mr-d80/Arduino-XP-BMS-MkII/hardware/with-EL-switch/Arduino-XP-BMS-MkII-picture-assembly.jpg

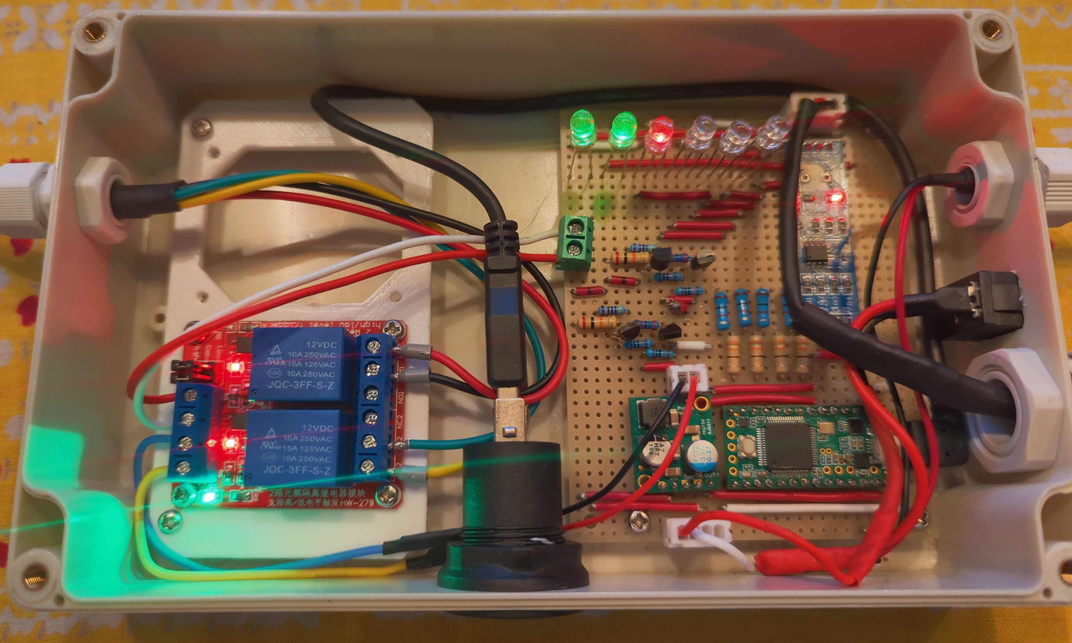
hardware/with-EL-switch/Arduino-XP-BMS-MkII-picture-assembly.jpg
