mr-d80/Arduino-XP-BMS-MkII/hardware/Arduino-XP-BMS-schematic.png

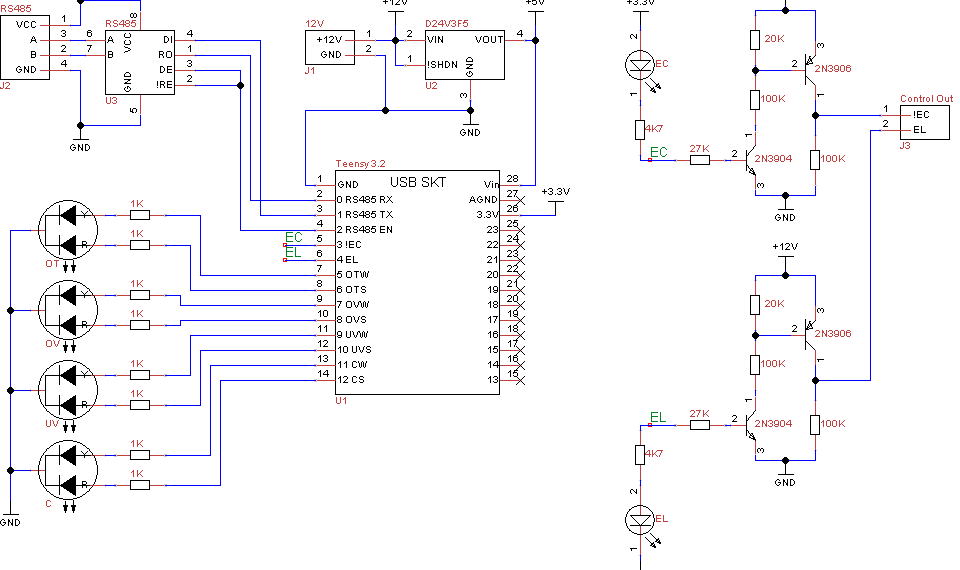
hardware/Arduino-XP-BMS-schematic.png
