mr-d80/Arduino-XP-BMS-MkII/(list of files, drawings)

Other design files:
hardware/with-EL-switch/Arduino-XP-BMS-MkII-schematic.dsn
