mr-d80/Arduino-XP-BMS-MkII/tests/BmsCoreTests/BmsCoreTests.ino

#include <Arduino.h>

#include <BmsCore.h>

uint16_t failures = 0;

void expectTrue(bool condition, const __FlashStringHelper *name) {
    if (condition) {
        Serial.print(F("PASS: "));
    } else {
        Serial.print(F("FAIL: "));
        ++failures;
    }
    Serial.println(name);
}

void runCrcTests() {
    const uint8_t request[] = {0x01, 0x03, 0x00, 0x00, 0x00, 0x0A};
    expectTrue(
        BmsCore::modbusCrc(request, sizeof(request)) == 0xCDC5,
        F("known Modbus CRC vector")
    );
}

void makeValidResponse(uint8_t *response) {
    const uint8_t initial[] = {0x02, 0x03, 0x02, 0x12, 0x34, 0x00, 0x00, 0x0D, 0x0A};
    memcpy(response, initial, sizeof(initial));
    const uint16_t crc = BmsCore::modbusCrc(response, 5);
    response[5] = static_cast<uint8_t>(crc & 0x00FFU);
    response[6] = static_cast<uint8_t>(crc >> 8U);
}

void runResponseValidationTests() {
    enum Mutation : uint8_t {
        VALID,
        SHORT,
        LONG,
        ADDRESS,
        FUNCTION,
        BYTE_COUNT,
        TERMINATOR,
        CRC
    };
    struct TestCase {
        Mutation mutation;
        BmsCore::ResponseError expected;
        const __FlashStringHelper *name;
    };
    const TestCase cases[] = {
        {VALID, BmsCore::ResponseError::None, F("valid response")},
        {SHORT, BmsCore::ResponseError::TooShort, F("short response")},
        {LONG, BmsCore::ResponseError::TooLong, F("long response")},
        {ADDRESS, BmsCore::ResponseError::Address, F("wrong address")},
        {FUNCTION, BmsCore::ResponseError::Function, F("wrong function")},
        {BYTE_COUNT, BmsCore::ResponseError::ByteCount, F("wrong byte count")},
        {TERMINATOR, BmsCore::ResponseError::Terminator, F("bad terminator")},
        {CRC, BmsCore::ResponseError::Crc, F("corrupt CRC")}
    };

    for (const TestCase &test : cases) {
        uint8_t response[10] = {};
        makeValidResponse(response);
        size_t received = 9;
        switch (test.mutation) {
            case SHORT: received = 8; break;
            case LONG: received = 10; break;
            case ADDRESS: response[0] = 3; break;
            case FUNCTION: response[1] = 4; break;
            case BYTE_COUNT: response[2] = 4; break;
            case TERMINATOR: response[8] = 0; break;
            case CRC: response[5] ^= 0x01U; break;
            case VALID: break;
        }
        expectTrue(
            BmsCore::validateResponse(response, received, 9, 2, 2) == test.expected,
            test.name
        );
    }
}

void runDecodeTests() {
    expectTrue(
        BmsCore::decodeUnsigned16(0x12, 0x34) == 0x1234,
        F("unsigned 16-bit decode")
    );
    expectTrue(
        BmsCore::decodeSigned16(0xFF, 0x9C) == -100,
        F("signed 16-bit decode")
    );
    expectTrue(BmsCore::socTenthsPercent(0) == 0, F("SOC lower endpoint"));
    expectTrue(BmsCore::socTenthsPercent(128) == 502, F("SOC midpoint rounding"));
    expectTrue(BmsCore::socTenthsPercent(255) == 1000, F("SOC upper endpoint"));
}

void runBalanceDiagnosticTests() {
    struct IdCase {
        const char *text;
        bool valid;
        uint8_t expectedId;
    };
    const IdCase idCases[] = {
        {"1", true, 1},
        {"48", true, 48},
        {"01", true, 1},
        {"", false, 0},
        {"0", false, 0},
        {"49", false, 0},
        {"+1", false, 0},
        {"1x", false, 0},
        {" 1", false, 0}
    };
    for (const IdCase &test : idCases) {
        uint8_t moduleId = 0;
        const bool valid = BmsCore::parseBalanceDiagnosticModuleId(test.text, moduleId);
        expectTrue(
            valid == test.valid && (!valid || moduleId == test.expectedId),
            F("strict balance diagnostic module ID parsing")
        );
    }

    struct StatusCase {
        uint16_t raw;
        bool generalActive;
    };
    const StatusCase statusCases[] = {
        {0x0000, false},
        {0x0001, false},
        {0x0100, true},
        {0x0200, false},
        {0x8100, true}
    };
    for (const StatusCase &test : statusCases) {
        expectTrue(
            BmsCore::balanceGeneralActive(test.raw) == test.generalActive,
            F("general balance activity uses only statusword bit 8")
        );
    }

    struct BankCase {
        uint8_t raw;
        uint8_t activeMask;
    };
    const BankCase bankCases[] = {
        {0xFF, 0x00},
        {0x3F, 0x00},
        {0xFE, 0x01},
        {0xFD, 0x02},
        {0x1D, 0x22},
        {0xDD, 0x22},
        {0x00, 0x3F},
        {0xC0, 0x3F},
        {0x80, 0x3F},
        {0xBF, 0x00}
    };
    for (const BankCase &test : bankCases) {
        expectTrue(
            BmsCore::activeBalanceBankMask(test.raw) == test.activeMask,
            F("bank activity is active-low over bits 0 through 5 only")
        );
    }

    struct EnableCase {
        uint16_t raw;
        bool enabled;
    };
    const EnableCase enableCases[] = {
        {0x0000, true},
        {0x0001, true},
        {0x0010, false},
        {0x0110, false},
        {0x0020, true}
    };
    for (const EnableCase &test : enableCases) {
        expectTrue(
            BmsCore::oemBalanceEnabled(test.raw) == test.enabled,
            F("OEM enable state uses register bit 4")
        );
    }

    struct ActivityCase {
        bool statuswordValid;
        uint16_t rawStatusword;
        bool bankStateValid;
        uint8_t rawBankState;
        BmsCore::BalanceActivity expectedActivity;
        int8_t expectedTelemetryBal;
        int16_t expectedBankMask;
    };
    const ActivityCase activityCases[] = {
        // Captured rev. 2 module: statusword bit 8 plus banks 2 and 6 active.
        {true, 0x0100, true, 0x1D, BmsCore::BalanceActivity::Active, 1, 0x22},
        // Captured rev. 1 module: bank flags alone report banks 2 through 6 active.
        {true, 0x0000, true, 0x01, BmsCore::BalanceActivity::Active, 1, 0x3E},
        {true, 0x0000, true, 0x3F, BmsCore::BalanceActivity::Inactive, 0, 0x00},
        {true, 0x0100, true, 0xFF, BmsCore::BalanceActivity::Active, 1, 0x00},
        // Upper two bits differ, but the six bank flags and result are unchanged.
        {true, 0x0000, true, 0xDD, BmsCore::BalanceActivity::Active, 1, 0x22},
        {false, 0x0100, false, 0x1D, BmsCore::BalanceActivity::Unavailable, -1, -1},
        {false, 0x0100, true, 0xFF, BmsCore::BalanceActivity::Unavailable, -1, 0x00},
        {true, 0x0000, false, 0x01, BmsCore::BalanceActivity::Unavailable, -1, -1}
    };
    for (const ActivityCase &test : activityCases) {
        const BmsCore::BalanceActivity activity = BmsCore::inferBalanceActivity(
            test.statuswordValid,
            test.rawStatusword,
            test.bankStateValid,
            test.rawBankState
        );
        expectTrue(
            activity == test.expectedActivity,
            F("combined balance activity matches captured and validity cases")
        );
        if (activity == BmsCore::BalanceActivity::Unavailable) {
            expectTrue(
                test.expectedTelemetryBal == -1,
                F("unavailable combined activity is not published as BAL zero")
            );
        } else {
            const uint8_t telemetryBal = activity == BmsCore::BalanceActivity::Active ? 1U : 0U;
            expectTrue(
                telemetryBal == static_cast<uint8_t>(test.expectedTelemetryBal),
                F("combined telemetry BAL maps active and inactive to 1 and 0")
            );
        }
        if (test.bankStateValid) {
            expectTrue(
                BmsCore::activeBalanceBankMask(test.rawBankState) ==
                    static_cast<uint8_t>(test.expectedBankMask),
                F("combined balance regression uses the six low active-low bank flags")
            );
        }
    }
}

void runThresholdTests() {
    expectTrue(BmsCore::assertHigh(3951, 3950), F("high alarm asserts above threshold"));
    expectTrue(!BmsCore::assertHigh(3950, 3950), F("high alarm excludes threshold"));
    expectTrue(BmsCore::clearHigh(3750, 3950, 200), F("high alarm clears at boundary"));
    expectTrue(!BmsCore::clearHigh(3751, 3950, 200), F("high alarm honors hysteresis"));
    expectTrue(BmsCore::assertLow(2599, 2600), F("low alarm asserts below threshold"));
    expectTrue(!BmsCore::assertLow(2600, 2600), F("low alarm excludes threshold"));
    expectTrue(BmsCore::clearLow(2800, 2600, 200), F("low alarm clears at boundary"));
    expectTrue(!BmsCore::clearLow(2799, 2600, 200), F("low alarm honors hysteresis"));
}

void runStorageTests() {
    const bool allValid[] = {true, true};
    const bool oneInvalid[] = {true, false};
    const uint16_t lowSoc[] = {400, 600};
    const uint16_t highSoc[] = {450, 500};

    BmsCore::StorageDecision decision =
        BmsCore::evaluateStorage(false, lowSoc, allValid, 2, 400, 500);
    expectTrue(decision.startCharging && !decision.stopCharging, F("storage starts at 40 percent"));

    decision = BmsCore::evaluateStorage(true, highSoc, allValid, 2, 400, 500);
    expectTrue(!decision.startCharging && decision.stopCharging, F("storage stops at 50 percent"));

    decision = BmsCore::evaluateStorage(true, highSoc, oneInvalid, 2, 400, 500);
    expectTrue(!decision.startCharging && !decision.stopCharging, F("invalid SOC holds storage state"));
}

void runIncompleteScanTests() {
    expectTrue(
        BmsCore::moduleScanComplete(true, true, true, true),
        F("four valid fields complete a scan")
    );
    expectTrue(
        !BmsCore::moduleScanComplete(true, true, false, true),
        F("one invalid field makes a scan incomplete")
    );

    BmsCore::CommunicationState state =
        BmsCore::evaluateCommunication(false, 0, false, 2);
    expectTrue(
        state.consecutiveFailures == 1 && state.warningLatched && !state.shutdown,
        F("first incomplete scan warns without shutdown")
    );
    state = BmsCore::evaluateCommunication(
        false,
        state.consecutiveFailures,
        state.warningLatched,
        2
    );
    expectTrue(
        state.consecutiveFailures == 2 && state.warningLatched && state.shutdown,
        F("second incomplete scan shuts down")
    );
    state = BmsCore::evaluateCommunication(
        true,
        state.consecutiveFailures,
        state.warningLatched,
        2
    );
    expectTrue(
        state.consecutiveFailures == 0 && state.warningLatched && !state.shutdown,
        F("complete scan clears shutdown but preserves warning latch")
    );
}

void runTimingTests() {
    expectTrue(
        BmsCore::intervalElapsed(5U, UINT32_MAX - 4U, 10U),
        F("millis rollover interval")
    );
    expectTrue(
        !BmsCore::intervalElapsed(5U, UINT32_MAX - 4U, 11U),
        F("millis rollover before interval")
    );
}

void setup() {
    Serial.begin(115200);
    delay(250);
    runCrcTests();
    runResponseValidationTests();
    runDecodeTests();
    runBalanceDiagnosticTests();
    runThresholdTests();
    runStorageTests();
    runIncompleteScanTests();
    runTimingTests();
    Serial.print(F("Failures: "));
    Serial.println(failures);
}

void loop() {}
