mr-d80/Arduino-XP-BMS-MkII/(commit log)

2026-09-10 Harden BMS telemetry and connect HC-06 directly
    [Arduino-XP-BMS-MkII-schematic.dsn, Arduino-XP-BMS-schematic.dsn]
2026-09-21 Stabilize HC-06 telemetry with 80 ms paced transmission
    [Arduino-XP-BMS-MkII.ino, PacedTelemetry.h]
2026-10-03 Fix telemetry BAL for bank-only module balancing
    [Arduino-XP-BMS-MkII.ino, BmsCoreTests.ino]
